SeeedDocument/Grove_Shield_for_Intel_Joule/img/2.png

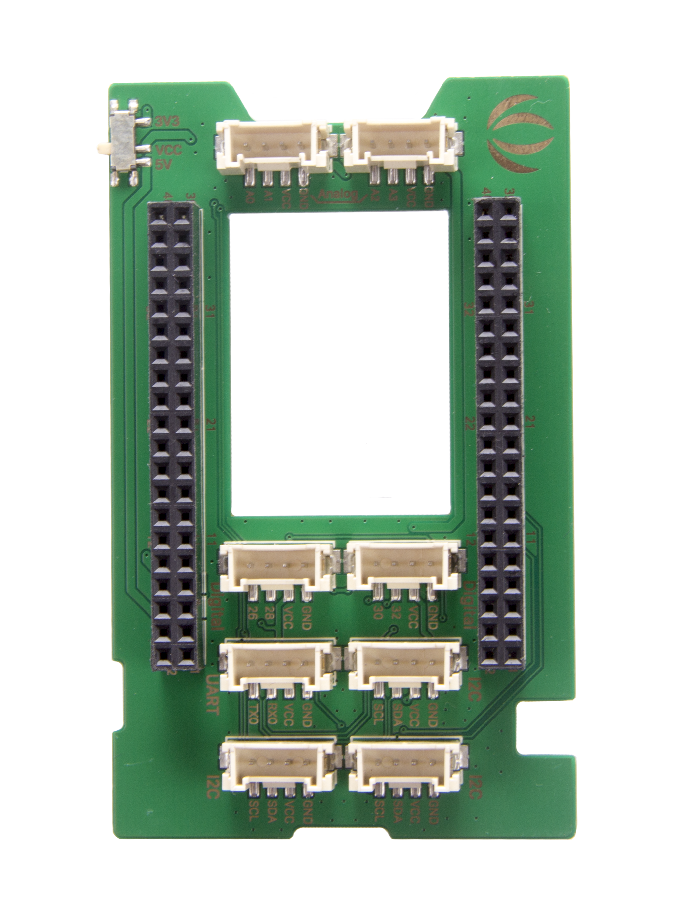
img/2.png
