SeeedDocument/Grove_Shield_for_Intel_Joule/img/new.png

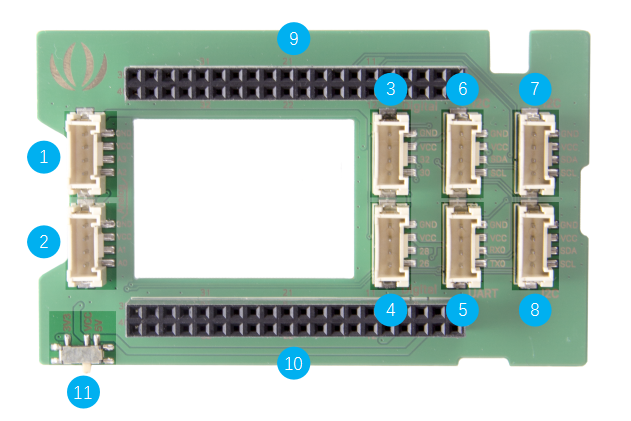
img/new.png
