SeeedDocument/Grove_Shield_for_Intel_Joule/res/Grove Shield for Intel Joule v1.0.pdf

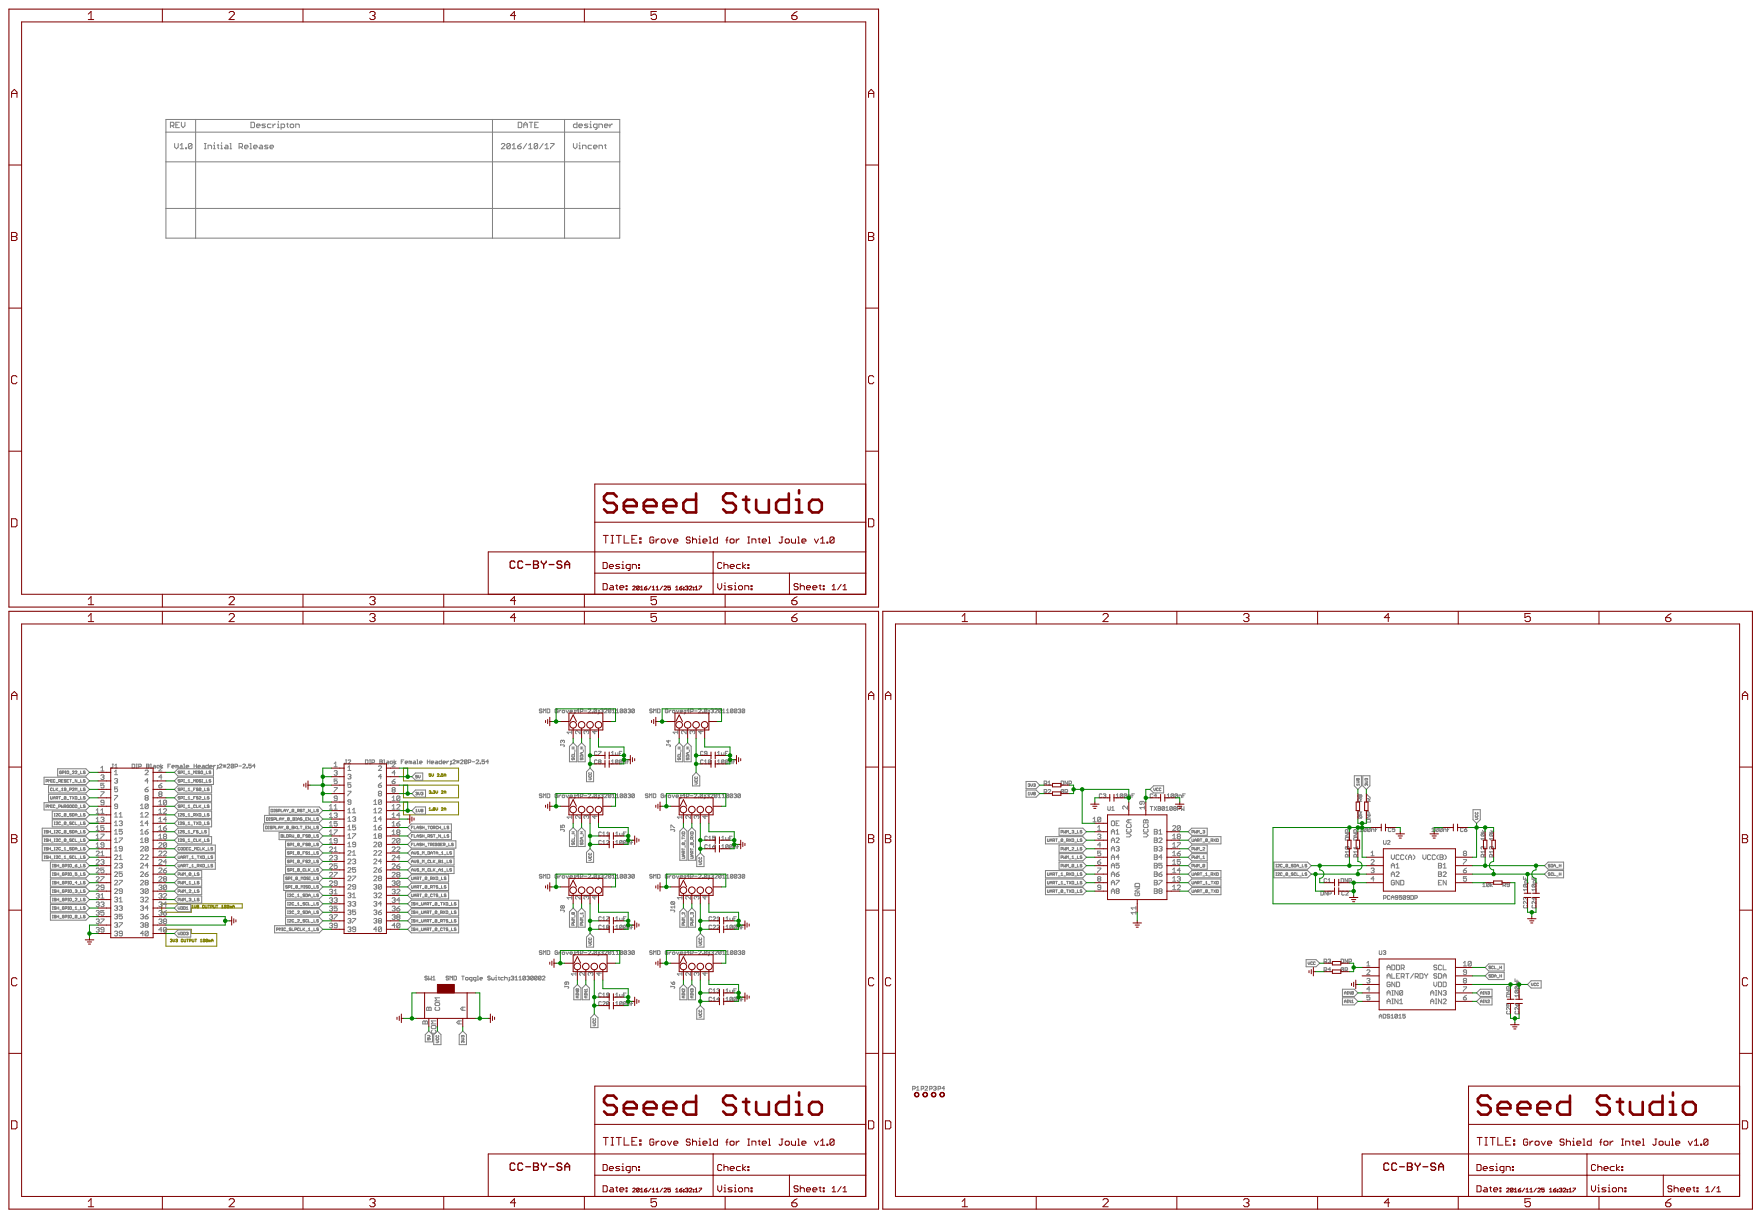
[picture p5: page 1]
