SeeedDocument/Grove_Shield_for_Intel_Joule/res/Grove Shield for Intel Joule v1.0.brd

## EAGLE design res/Grove Shield for Intel Joule v1.0.brd (2016-12-27)

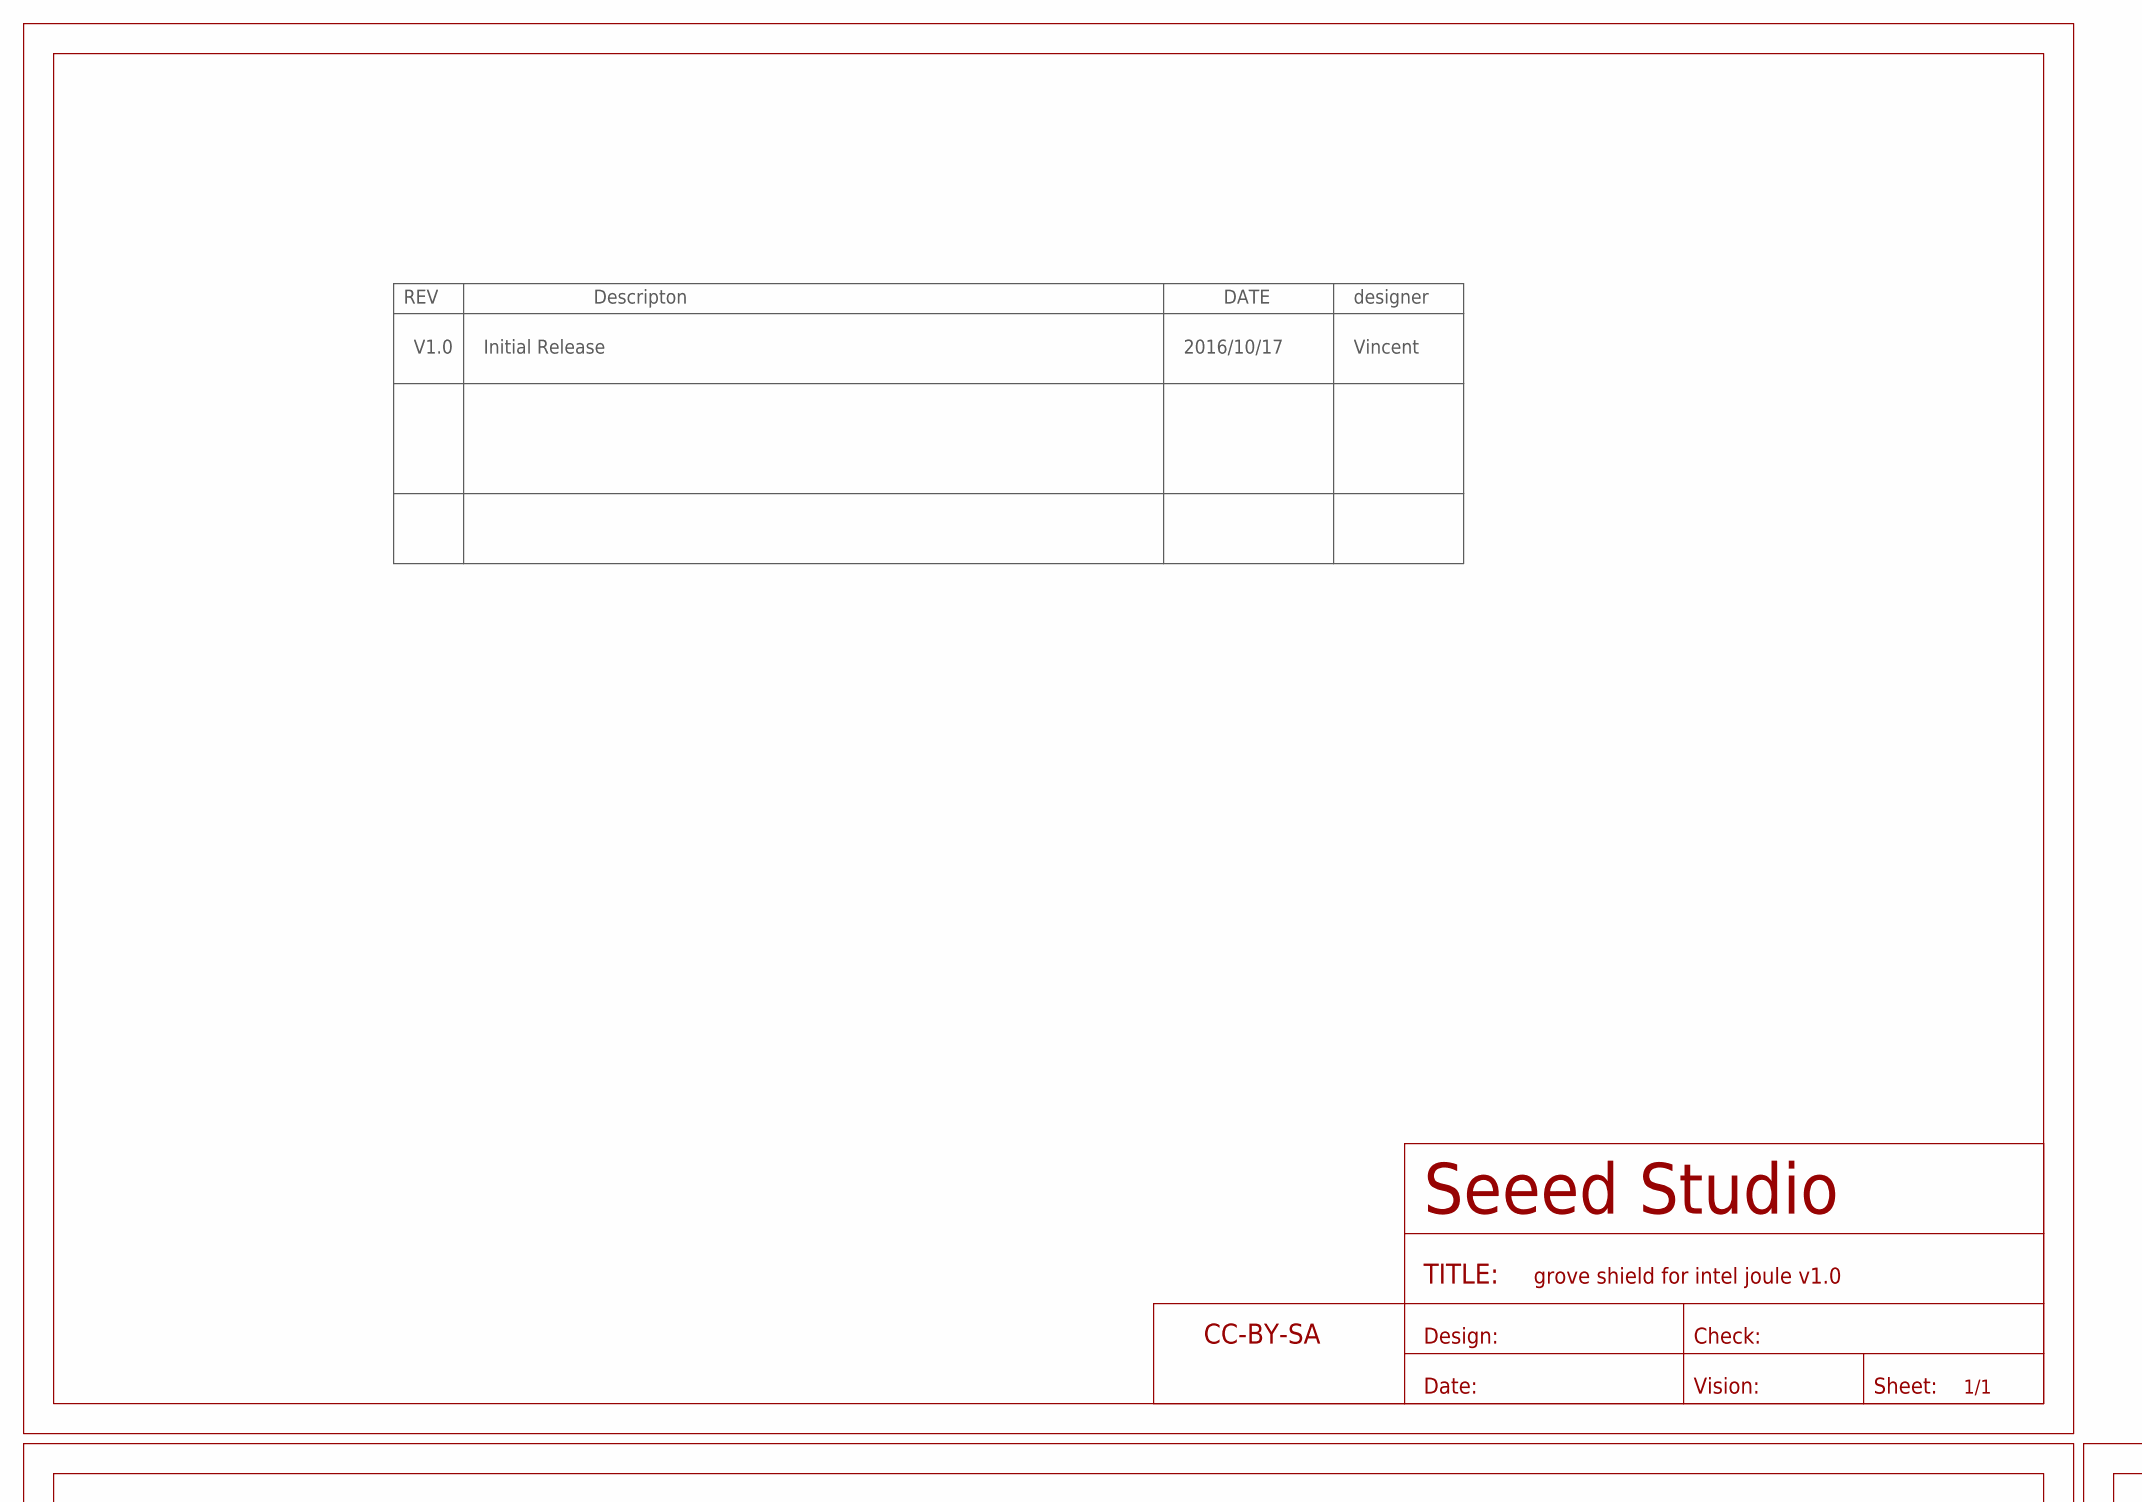
[picture p6: schematic Grove Shield for Intel Joule v1.0.sch, part in row 1, column 1]

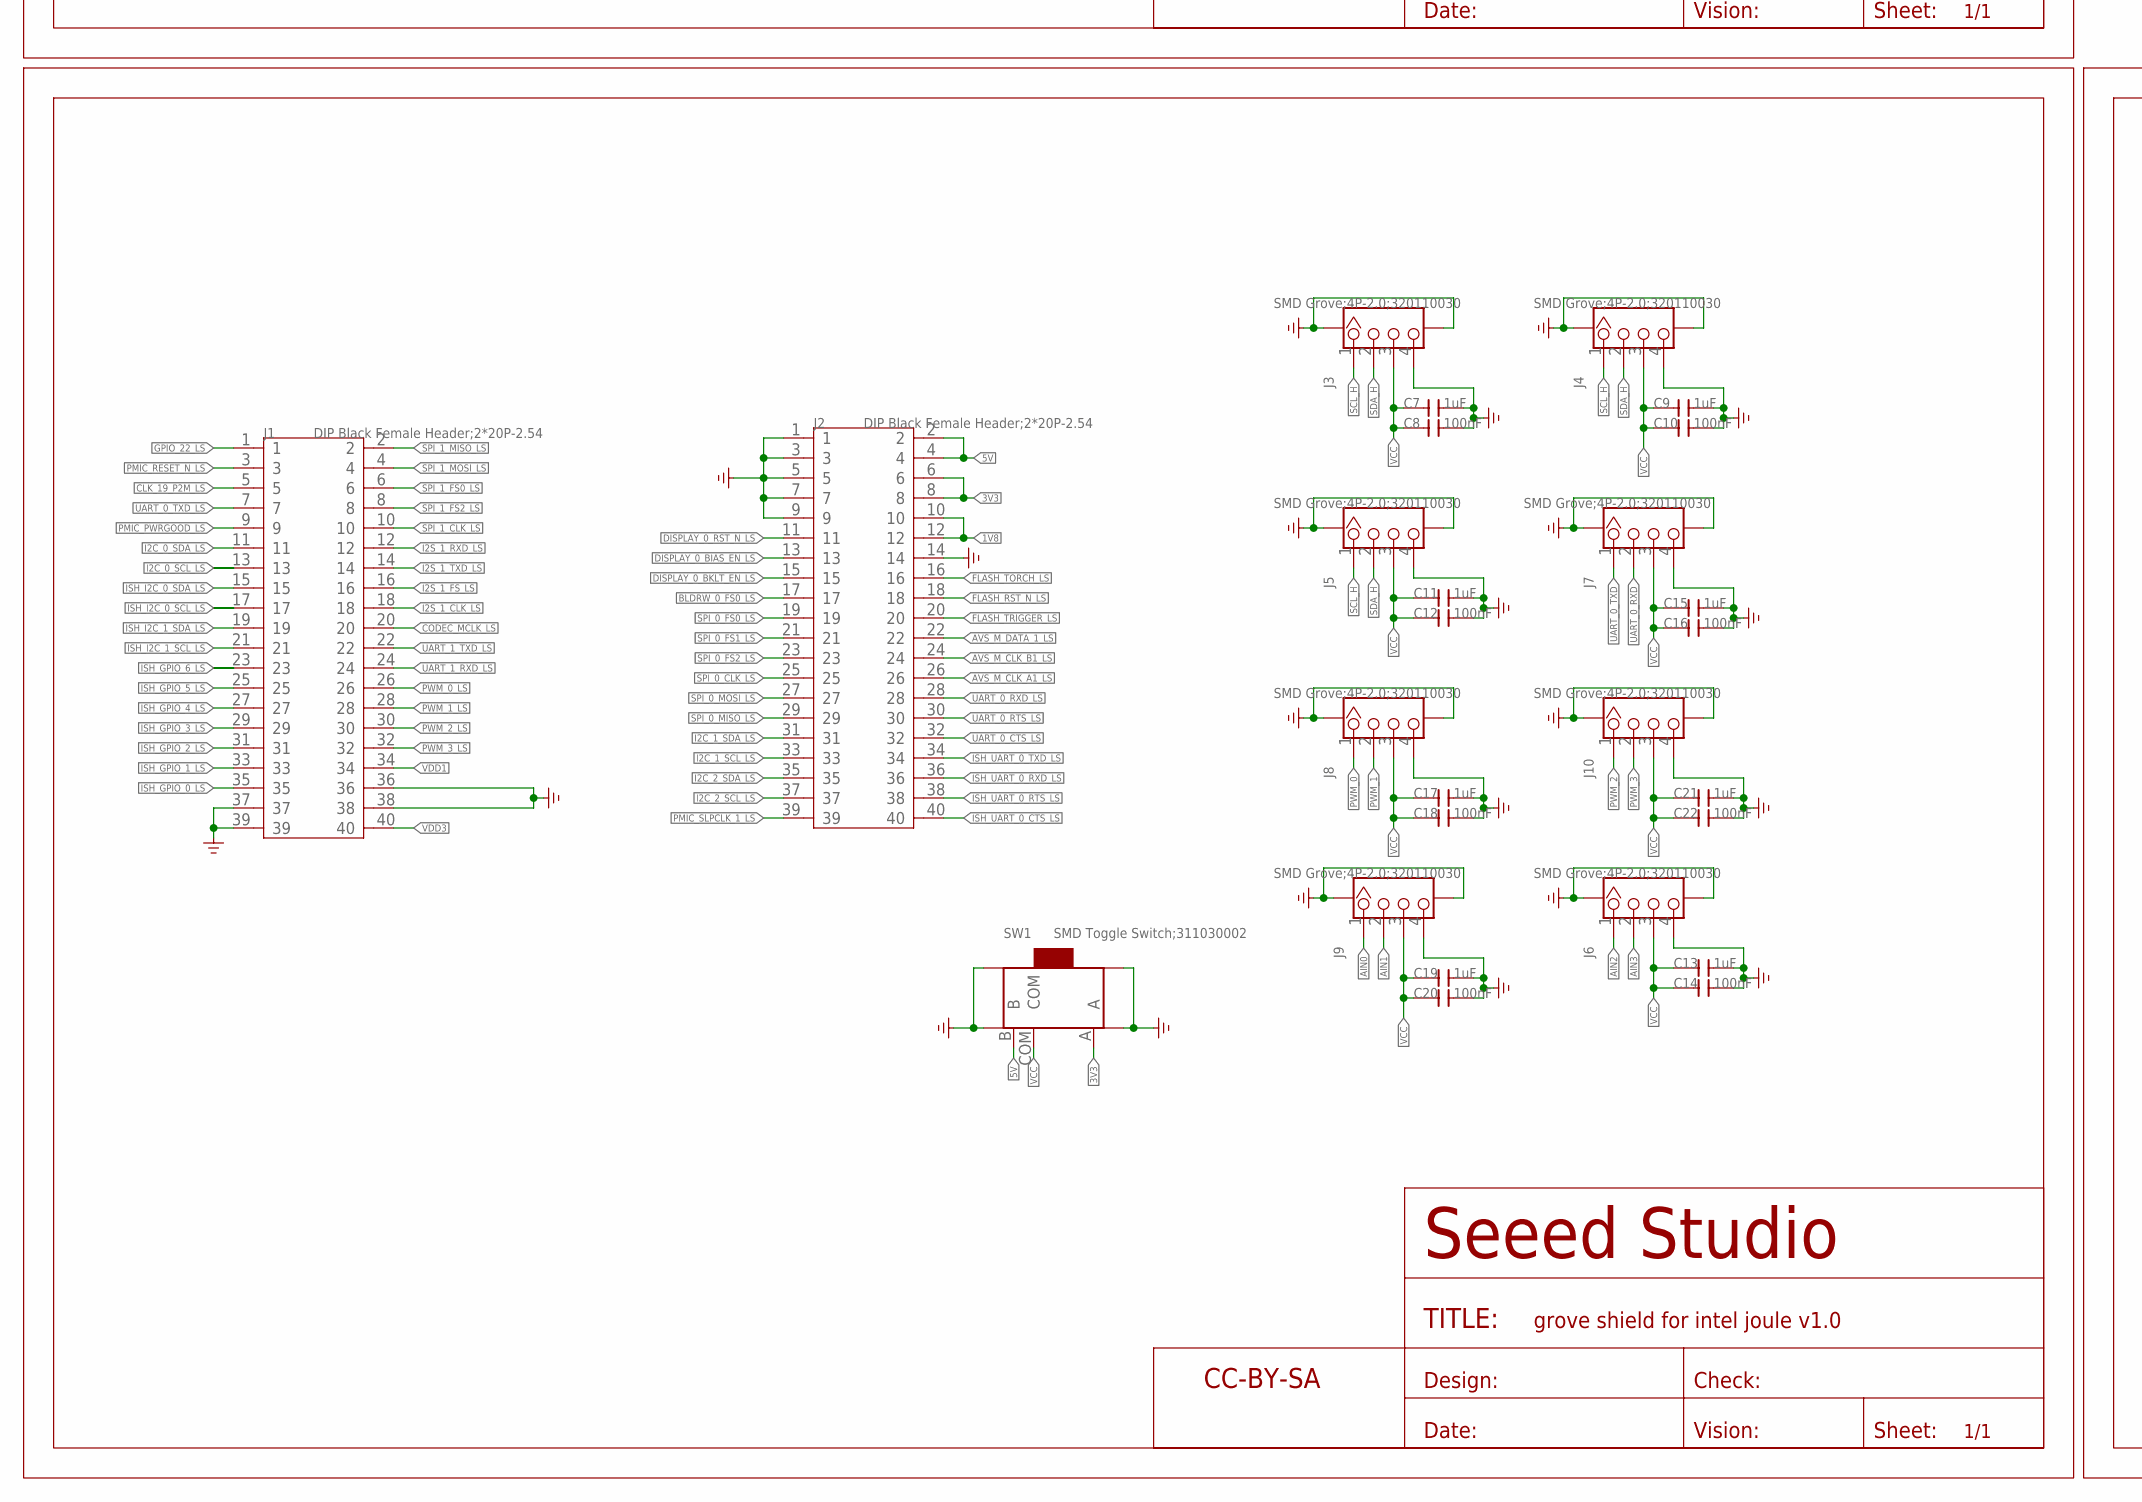
[picture p7: schematic Grove Shield for Intel Joule v1.0.sch, part in row 2, column 1]

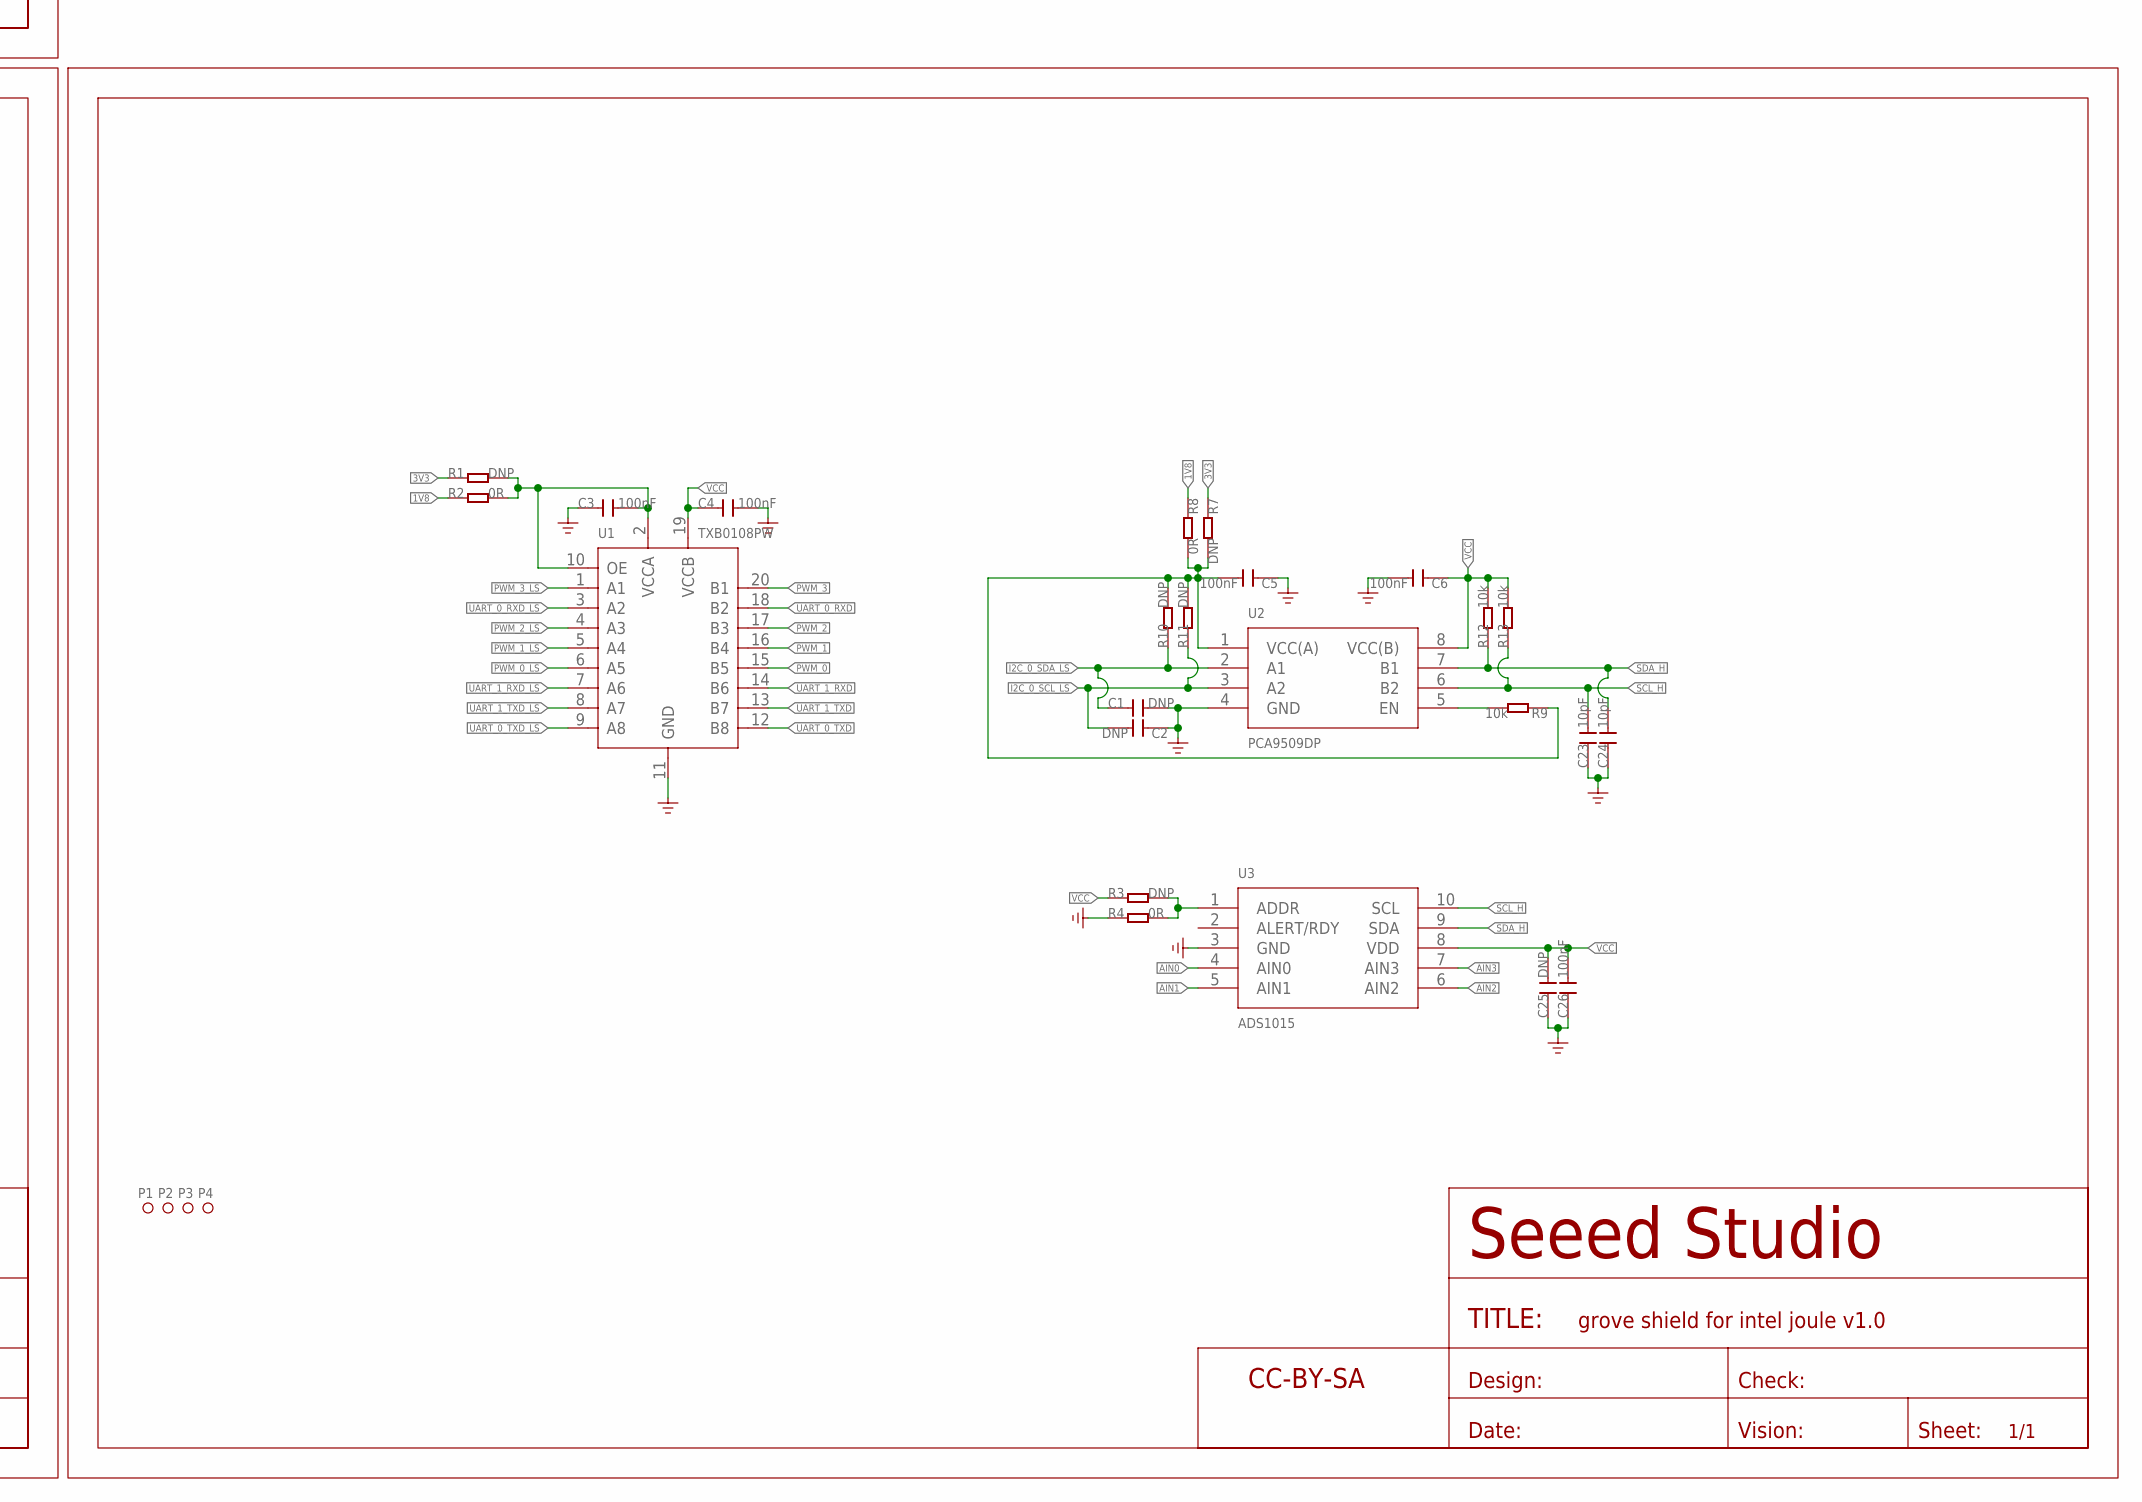
[picture p8: schematic Grove Shield for Intel Joule v1.0.sch, part in row 2, column 2]

Parts:
C1, C2, C25: DNP; C0603
C3, C4, C5, C6, C8, C10, C12, C14, C16, C18, C20, C22, C26: 100nF; C0603
C7, C9, C11, C13, C15, C17, C19, C21: 1uF; C0603
C23, C24: 10pF; C0603
FR1, FR2, FR3: SEEEDSTUDIO-OPEN-SCH-FRAME; SEEEDSTUDIO-PCB-FRAME
J1, J2: DIP Black Female Header;2*20P-2.54; H2X20-2.54MM
J3, J4, J5, J6, J7, J8, J9, J10: SMD Grove;4P-2.0;320110030; HW4-SMD-2.0
P1, P2, P3, P4: MARK-1.0'ANNULAR'; ROUND-MARK-1.0
R1, R3, R7, R10, R11: DNP; R0603
R2, R4, R8: 0R; R0603
R9, R12, R13: 10k; R0603
SW1: SMD Toggle Switch;311030002; SW7-SMD-6.7X2.6X1.4MM-90D
U1: TXB0108PW; TSSOP20-0.65-6.5X4.4MM
U2: PCA9509DP; TSSOP8-0.65-3X3MM
U3: ADS1015; SSOP10-0.5-3X3MM

Connections:
1V8: J2.10, J2.12, R2.1, R8.1
3V3: J2.6, J2.8, R1.1, R7.1, SW1.A
5V: J2.2, J2.4, SW1.B
AIN0: J9.1, U3.4 (AIN0)
AIN1: J9.2, U3.5 (AIN1)
AIN2: J6.1, U3.6 (AIN2)
AIN3: J6.2, U3.7 (AIN3)
AVS_M_CLK_A1_LS: J2.26
AVS_M_CLK_B1_LS: J2.24
AVS_M_DATA_1_LS: J2.22
BLDRW_0_FS0_LS: J2.17
CLK_19_P2M_LS: J1.5
CODEC_MCLK_LS: J1.20
DISPLAY_0_BIAS_EN_LS: J2.13
DISPLAY_0_BKLT_EN_LS: J2.15
DISPLAY_0_RST_N_LS: J2.11
FLASH_RST_N_LS: J2.18
FLASH_TORCH_LS: J2.16
FLASH_TRIGGER_LS: J2.20
GND: C1.2, C2.1, C3.1, C4.2, C5.1, C6.2, C7.2, C8.2, C9.2, C10.2, C11.2, C12.2, C13.2, C14.2, C15.2, C16.2, C17.2, C18.2, C19.2, C20.2, C21.2, C22.2, C23.1, C24.1, C25.1, C26.1, J1.36, J1.37, J1.38, J1.39, J2.1, J2.3, J2.5, J2.7, J2.9, J2.14, J3.4, J3.SS1, J3.SS2, J4.4, J4.SS1, J4.SS2, J5.4, J5.SS1, J5.SS2, J6.4, J6.SS1, J6.SS2, J7.4, J7.SS1, J7.SS2, J8.4, J8.SS1, J8.SS2, J9.4, J9.SS1, J9.SS2, J10.4, J10.SS1, J10.SS2, R4.1, SW1.P1 (SS1), SW1.P2 (SS2), SW1.P3 (SS3), SW1.P4 (SS4), U1.11 (GND), U2.4 (GND), U3.3 (GND)
GPIO_22_LS: J1.1
I2C_0_SCL_LS: C2.2, J1.13, R11.1, U2.3 (A2)
I2C_0_SDA_LS: C1.1, J1.11, R10.1, U2.2 (A1)
I2C_1_SCL_LS: J2.33
I2C_1_SDA_LS: J2.31
I2C_2_SCL_LS: J2.37
I2C_2_SDA_LS: J2.35
I2S_1_CLK_LS: J1.18
I2S_1_FS_LS: J1.16
I2S_1_RXD_LS: J1.12
I2S_1_TXD_LS: J1.14
ISH_GPIO_0_LS: J1.35
ISH_GPIO_1_LS: J1.33
ISH_GPIO_2_LS: J1.31
ISH_GPIO_3_LS: J1.29
ISH_GPIO_4_LS: J1.27
ISH_GPIO_5_LS: J1.25
ISH_GPIO_6_LS: J1.23
ISH_I2C_0_SCL_LS: J1.17
ISH_I2C_0_SDA_LS: J1.15
ISH_I2C_1_SCL_LS: J1.21
ISH_I2C_1_SDA_LS: J1.19
ISH_UART_0_CTS_LS: J2.40
ISH_UART_0_RTS_LS: J2.38
ISH_UART_0_RXD_LS: J2.36
ISH_UART_0_TXD_LS: J2.34
unnamed: R9.2, U2.5 (EN)
unnamed: R3.2, R4.2, U3.1 (ADDR)
unnamed: C5.2, R7.2, R8.2, R9.1, R10.2, R11.2, U2.1 (VCC(A))
unnamed: C3.2, R1.2, R2.2, U1.2 (VCCA), U1.10 (OE)
PMIC_PWRGOOD_LS: J1.9
PMIC_RESET_N_LS: J1.3
PMIC_SLPCLK_1_LS: J2.39
PWM_0: J8.1, U1.15 (B5)
PWM_0_LS: J1.26, U1.6 (A5)
PWM_1: J8.2, U1.16 (B4)
PWM_1_LS: J1.28, U1.5 (A4)
PWM_2: J10.1, U1.17 (B3)
PWM_2_LS: J1.30, U1.4 (A3)
PWM_3: J10.2, U1.20 (B1)
PWM_3_LS: J1.32, U1.1 (A1)
SCL_H: C23.2, J3.1, J4.1, J5.1, R13.1, U2.6 (B2), U3.10 (SCL)
SDA_H: C24.2, J3.2, J4.2, J5.2, R12.1, U2.7 (B1), U3.9 (SDA)
SPI_0_CLK_LS: J2.25
SPI_0_FS0_LS: J2.19
SPI_0_FS1_LS: J2.21
SPI_0_FS2_LS: J2.23
SPI_0_MISO_LS: J2.29
SPI_0_MOSI_LS: J2.27
SPI_1_CLK_LS: J1.10
SPI_1_FS0_LS: J1.6
SPI_1_FS2_LS: J1.8
SPI_1_MISO_LS: J1.2
SPI_1_MOSI_LS: J1.4
UART_0_CTS_LS: J2.32
UART_0_RTS_LS: J2.30
UART_0_RXD: J7.2, U1.18 (B2)
UART_0_RXD_LS: J2.28, U1.3 (A2)
UART_0_TXD: J7.1, U1.12 (B8)
UART_0_TXD_LS: J1.7, U1.9 (A8)
UART_1_RXD: U1.14 (B6)
UART_1_RXD_LS: J1.24, U1.7 (A6)
UART_1_TXD: U1.13 (B7)
UART_1_TXD_LS: J1.22, U1.8 (A7)
VCC: C4.1, C6.1, C7.1, C8.1, C9.1, C10.1, C11.1, C12.1, C13.1, C14.1, C15.1, C16.1, C17.1, C18.1, C19.1, C20.1, C21.1, C22.1, C25.2, C26.2, J3.3, J4.3, J5.3, J6.3, J7.3, J8.3, J9.3, J10.3, R3.1, R12.2, R13.2, SW1.COM, U1.19 (VCCB), U2.8 (VCC(B)), U3.8 (VDD)
VDD1: J1.34
VDD3: J1.40

Notes on the sheet:
REV
Descripton
DATE
designer
V1.0
Initial Release
2016/10/17
Vincent

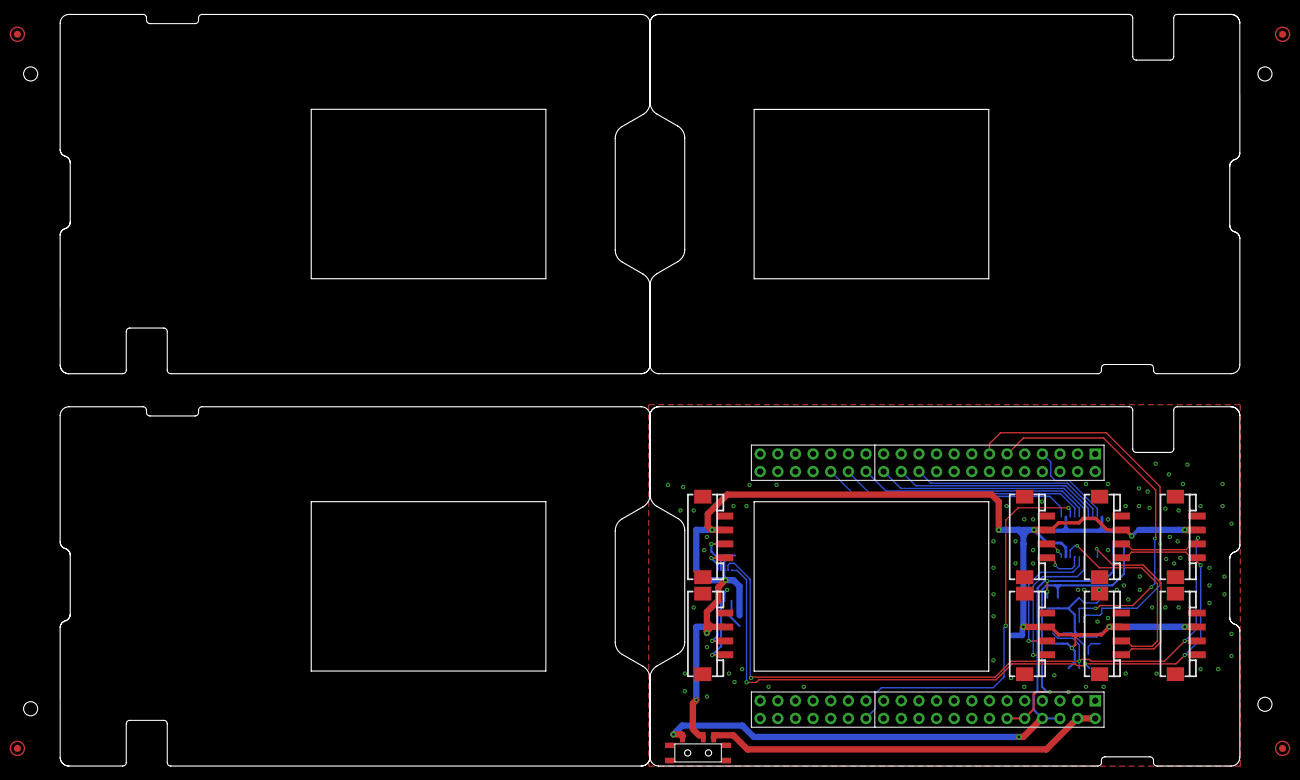
[picture p9: board Grove Shield for Intel Joule v1.0.brd from above]

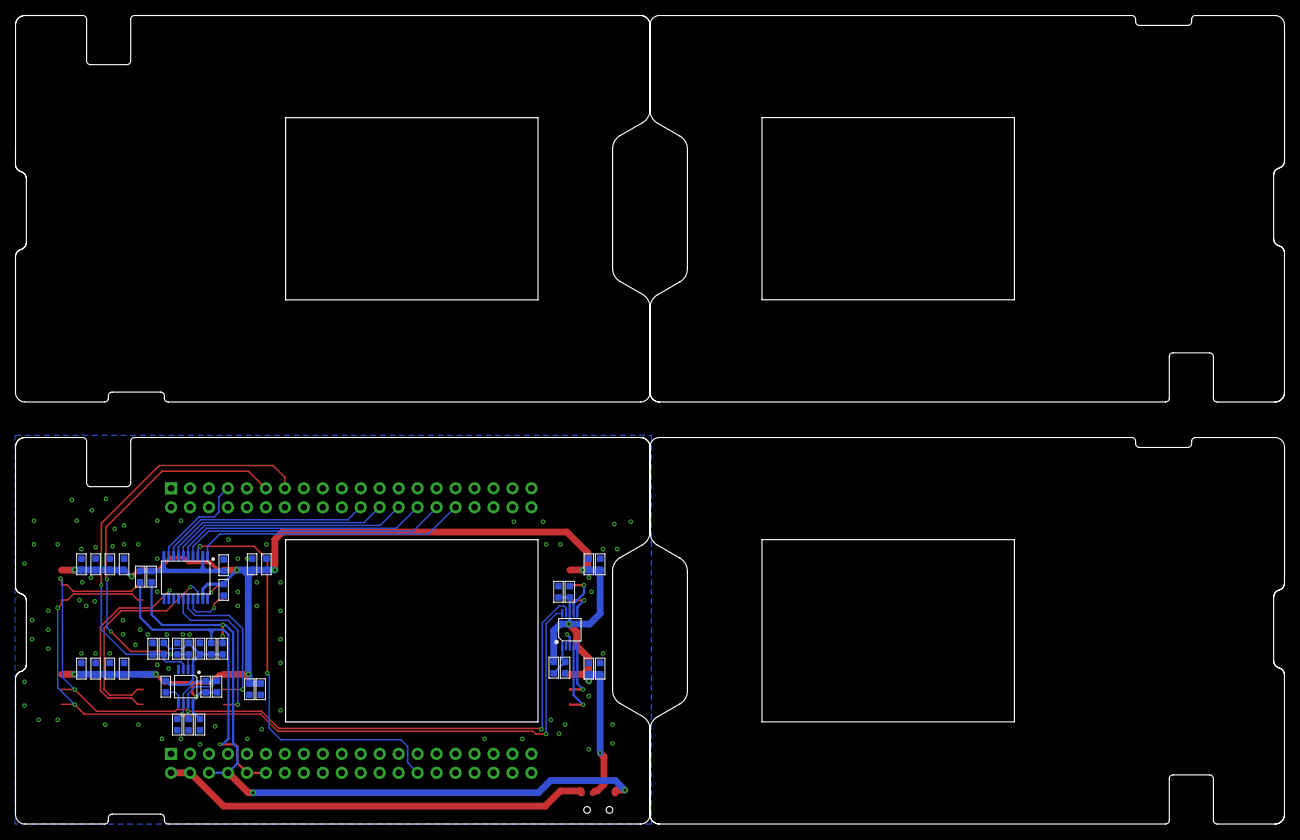
[picture p10: board Grove Shield for Intel Joule v1.0.brd from below]

Board: 2 copper layers, 169.9 x 108.3 mm, 58 parts (40 on the bottom side), 31 nets.
